acamilo/RobotInterfaceBoard/docs/board.jpeg

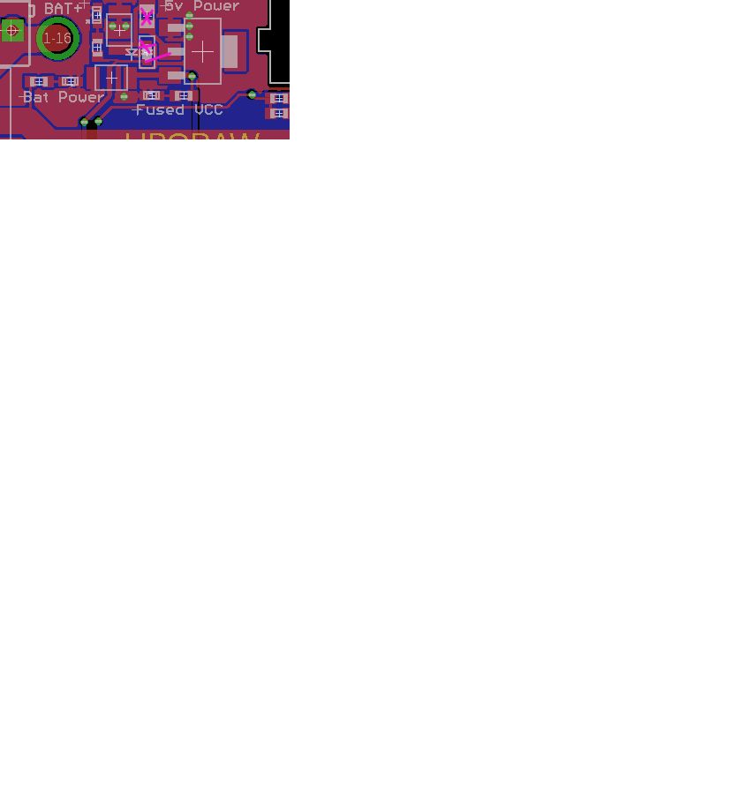
docs/board.jpeg
