acamilo/RobotInterfaceBoard/docs/pickWorkspace.png

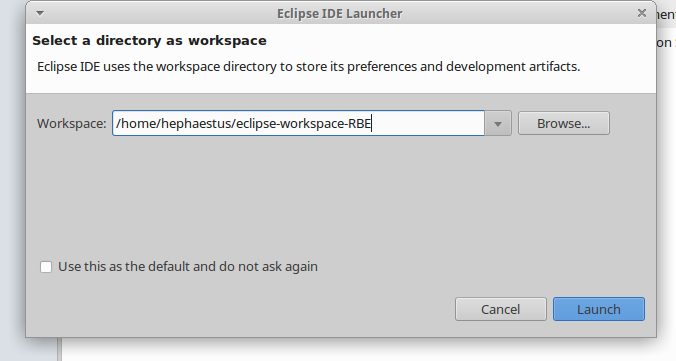
docs/pickWorkspace.png
