acamilo/RobotInterfaceBoard/BOM.xls

Part | Source | Value | Digi-key
C1,C2 | yes | 1210 Capacitor 16v 22uF | 490-1882-1-ND
F4 | no | FUSE BLOCK BLADE 500V 30A PCB | 36-3557-2-ND
IC1 | yes | IC REG LINEAR 5V SOT223 | AZ1117CH-5.0TRG1DICT-ND
J1 | yes | 2 Position Wire to Board Terminal Block | 609-4725-ND
SW1 | no | SWITCH SLIDE DPDT 8.5A 125V | CW174-ND
JP3,JP6,JP7,JP17,JP5,JP19,JP18,JP4,JP2,JP8 | yes | 1X19 0.1” header female | S7017-ND
LED1,LED2,LED3,LED4 | yes | 0603 green LED | 160-1446-1-ND
R1,R2,R3,R4 | yes | 330 ohm Resistors | CR0603-JW-331ELFCT-ND
R5,R6 | yes | 4.7k i2c resistor | RMCF0603JT4K70CT-ND
D1 | no | SOD-523 diode | 1N4148XTPMSCT-ND
PTC | no | PTC fuse 500mA | 490-12122-1-ND
