acamilo/RobotInterfaceBoard/docs/ESP32-setup.png

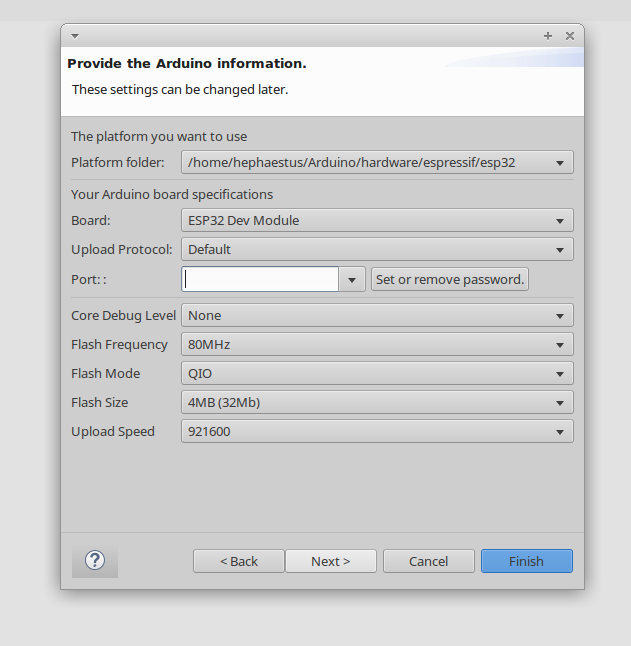
docs/ESP32-setup.png
