acamilo/RobotInterfaceBoard/docs/makeSureThereAreNoSpaces.png

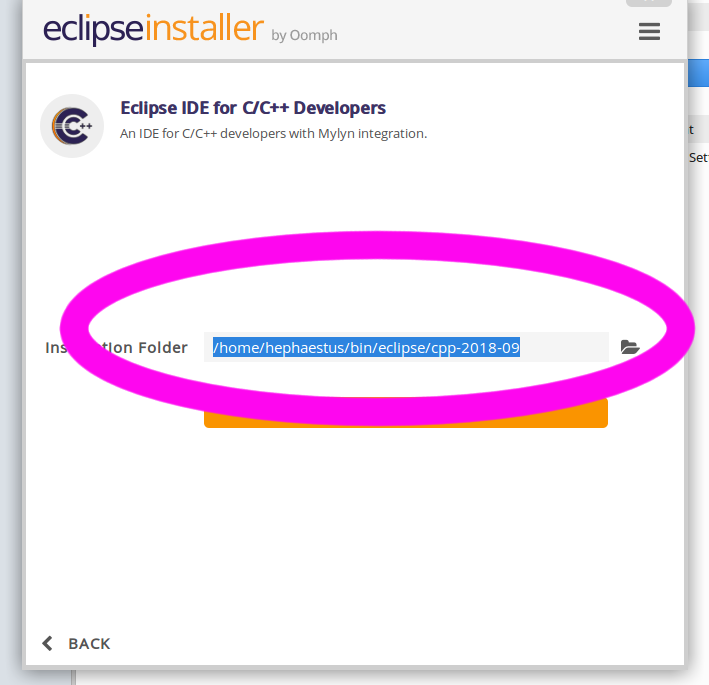
docs/makeSureThereAreNoSpaces.png
