acamilo/RobotInterfaceBoard/docs/fix.png

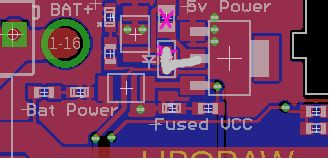
docs/fix.png
