acamilo/RobotInterfaceBoard/(threads)

Thread 2 (2018-02-14):

Battery connector needs to be just a solder lug or screw terminals

madhephaestus, 2018-02-14:
Tamya batteries (RC/Vex standard) will be used.

madhephaestus, 2018-02-15:
When you close issues, do it by putting " close #2 " in the commit message (for this issues example). Otherwise add a comment to the issue with a link to the commit that resolved it.

Thread 3 (2018-02-14):

i2c on the ESP32 pinout is wrong

madhephaestus, 2018-02-14:
SDA is wired to the wrong pin, SCL is correct

SDA is on pin 21

https://1.bp.blogspot.com/-RL8tkZprmjc/WMxXKaIgocI/AAAAAAAAALw/xLM5Qt3jgSALQ_hHRaurJswgGK5G4wVxwCLcB/s1600/myESP32%2BDevKitC%2Bpinout.png

madhephaestus, 2018-02-15:
was this addressed in 6599b58898455c9383d5c74dc5f69e0b3ae3689a

Closed 2018-02-27.

Thread 5 (2018-02-14):

Full-turn order needs to be prepared

madhephaestus, 2018-02-14:
A full-turn of all components assembled onto the PCB is the deliverable for this project. Only the solder lug for the battery should be left out of the full turn.

Closed 2018-03-02.

Thread 6 (2018-02-14):

Fuse and HV traces need to be rated at 10 amps

madhephaestus, 2018-02-14:
The high voltage rail should be rated for 10 amps. The spade/micro automotive style fuse block is preferred.

acamilo, 2018-02-27:
You can get 8 amps if we order with 2oz copper.

Closed 2018-02-27.

Thread 7 (2018-02-15):

Label The power and ground rails in the silk screen

madhephaestus, 2018-02-15:
The nominal voltage on each rail should be labeled

acamilo, 2018-02-27:
e11350b2db6f91e75a6885dfff64264cca3c1889

Closed 2018-02-27.

Thread 8 (2018-02-15):

Label the WII connector pins

madhephaestus, 2018-02-15:
Power, ground, SDA, SCL and controller connect should be labeled.

acamilo, 2018-02-27:
328f9fd04364140250007d0a941541ac70eef136

Closed 2018-02-27.

Thread 9 (2018-02-15):

Controller detect pin should go to the microcontroller

madhephaestus, 2018-02-15:
Both the ESP32 and Teensy should have the controller detect pin rout to an IO pin. If the controller detect needs a pull up or pull down to work, add that as well to the pin.

acamilo, 2018-02-27:
49d743ca390d077daf4d072be6042b93ec0343ef

madhephaestus, 2018-02-27:
which IO pin does it go to?

acamilo, 2018-02-27:
32 on teensy and 23 on esp

madhephaestus, 2018-04-09:
please move the controller detect to a non servo/non SPI pin. Pin GPIO27 is ideal. Did you add a pull-up or pull down?

Closed 2018-02-27.

Thread 13 (2018-03-11):

Fuse is difficult to remove, needs to be moved on Esp32

madhephaestus, 2018-03-11:
The fuse on the Esp32 is very difficult to remove. If it were moved close to the HV rial, then it would be much easier. Pliers need a 15mm keep-away on either side of the open section of the fuse holder. Right now both the switch and the delicate antenna are in the way fr a clean fuse removal.

acamilo, 2018-03-22:
Replaced both fuses with a blade style automotive fuse.

Closed 2018-03-22.

Thread 14 (2018-03-11):

Fuse good/external power/Regulator good indicator LED's needed

madhephaestus, 2018-03-11:
There should be 3 LED's, one for the battery, one for the battery after the fuse, one for the 5v rail. In production environment of use cases with these modules, a visual check is a huge time saver.

acamilo, 2018-03-22:
Added.

Closed 2018-03-22.

Thread 15 (2018-03-11):

Centroid file doesn't contain any connectors

madhephaestus, 2018-03-11:
I was attempting to parse the centroid file to obtain the connector and switch locations for accurate cad. This information is missing.

madhephaestus, 2018-03-21:
This would prevent this part being added to the assembly quote, so what got quoted?

acamilo, 2018-03-22:
Manufacturer does not require centroids for through hole parts.

Closed 2018-03-22.

Thread 18 (2018-03-22):

Fix footprint for fuse holder

acamilo, 2018-03-22:

acamilo, 2018-04-13:
commit 378948bfd3b973c9b04a3b0fbeefe2d49848e643

Closed 2018-04-13.

Thread 19 (2018-03-28):

4k7 ohm pullups to 3.3v are needed on SDA and SCL

madhephaestus, 2018-03-28:
A pullup between SDA and 3.3 and SCL and 3.3 is needed for stable I2C communications across all commercially availible Wii devices. SOme devices have pullups built in, but these devices are unaffected by the external pullups. Some devices do not have these resistors built in and are unstable on the board without them.

madhephaestus, 2018-03-28:
This has been tested and validated as the stable solution in all cases for the Wii devices as a single device on the i2C port. When busing, this may be an issue.

madhephaestus, 2018-04-03:
Note this is needed on both the ESP32 and the Teensy

acamilo, 2018-04-12:
commit ecb4b3a3e98c0dec2cd3e581c8bc03964b119612

Closed 2018-04-12.

Thread 20 (2018-03-28):

BOM needs be updated for v 5.1

madhephaestus, 2018-03-28:
The BOM still lists the SMT style fuse holder

madhephaestus, 2018-05-03:
depends on #25

acamilo, 2018-05-07:
commit 120b008ea8a7410b9db4549d1077ed1a1c80a222

Closed 2018-05-07.

Thread 21 (2018-03-28):

Fuse for the 3.3v regulator is needed (Value is in question)

madhephaestus, 2018-03-28:
A fuse to gracefully fail after the 3.3v rail is plugged directly into gnd, or if the modules 3.3v rail is shorted directly to ground. I assume 75% of the regulators maximum output is sufficient. Be sure to also look at the power spec for the ESP development boards built in. This regulator has fried on a large-ish number of our testing boards. Changing those fusing is much better than replacing all of the power regulators *when* the students short power to ground.

madhephaestus, 2018-03-28:
An additional LED for the 3.3v rail should be here added. I will need to be able to power the module on and see at a glance if all the power rails are up and running.

acamilo, 2018-04-13:
commit 5c16eed2d937238d69e448bf987ce9fe361f2ba1

Closed 2018-04-13.

Thread 22 (2018-04-02):

Solder lugs resized to 3MM diameter holes and moved

madhephaestus, 2018-04-02:
The solder lugs should be one on either side of the screw terminals. The negative lig next to the negative screw terminal, the positive lug next to the positive terminal.

The hole size should also increased to a 3mm diameter.

acamilo, 2018-04-12:
commit aa292d349034c036d6087202d747d3fdc3d7bb37

Closed 2018-04-12.

Thread 24 (2018-04-02):

New SS lables for Analog and servo

madhephaestus, 2018-04-02:
the block of pins that can be analog are:
The ADC driver API currently only supports ADC1 (9 channels, attached to GPIOs 32-39).

They should have some sort of block label. The only area of the board visable to the user is between the 3 pin header and the 1xX header, so maybe highlight the IO or make it inverted colors?

PWM capable pins should be labled too as servos

acamilo, 2018-04-26:
commit f520d1e9d8a9c18e37b3da901794a7398df4641f

Closed 2018-04-26.

Thread 25 (2018-04-03):

Change the last male header, the 1xN, to female.

madhephaestus, 2018-04-03:
This llows solid wire to jumper from one pin to another. It also allows adding caps and resistors on the fly to a pin without disturbing its IO nor resorting to a female wire.

acamilo, 2018-05-07:
commit 120b008ea8a7410b9db4549d1077ed1a1c80a222

Closed 2018-05-07.

Thread 26 (2018-04-03):

Disconnect specific IO used by System Resources on ESP32

madhephaestus, 2018-04-03:
These should be availible in the 1xN header, but stop short of the 3 pin header bank. Thier SS should be changed from the GPIO lable to the name of the perpheral that is consuming them.

Setting any flash GPIO to Servo the module fails to boot. Using the boot pin causes unreliable programming. Using the Wii pins causes the Wii to fail.

Used by Flash:
GPIO6
GPIO7
GPIO8
GPIO9
GPIO10
GPIO11

Used as boot flag:

GPIO0

Used by Wii

GPIO21
GPIO22

Thread 27 (2018-04-03):

Label Signal Power Gnd on the low voltage side

madhephaestus, 2018-04-03:
The High voltage side is labeled, the other side needs labels too.

acamilo, 2018-04-30:
commit 10fba1676815b0f92a9e55add8aa241042beac04

Closed 2018-04-30.

Thread 28 (2018-04-04):

README is needed with with images of the PCB

madhephaestus, 2018-04-04:
The pin-out chart and images of the PCB should be documented in a readme.

acamilo, 2018-04-30:
image and readme. commit aacbf4db9cf578f667deced08ac7219cd93af76e

Closed 2018-04-30.

Thread 30 (2018-04-04):

5v pin outputs 2.72 volts when on battery

madhephaestus, 2018-04-04:
This pin should be removed from the IO interface as its voltage will vary widely based on if you are on battery or plugged in via USB.

Alternantly a separate 5v regulator could be added to that pin to supply voltage for the ESP32. This would keep the interface consistent through modes.

Do not replace the 3.3v regulator, it should be used to provide current for the sensors, should not come from the ESP32 built in regulator unless a a fuse is placed in line the prevent overcurrent of the 3.3 rail

Thread 31 (2018-04-08):

Label servo possible pins with a "~"

madhephaestus, 2018-04-08:
On these pins:
2,4,12-19,21-23,25-27,32-33

place a ~ to denote servo capable. The library for servos on the ESP32 enforces this and will not start servo on any of the other pins.

madhephaestus, 2018-04-08:
See this section in the (now official) esp32 servo library:
https://github.com/madhephaestus/ESP32Servo/blob/master/src/ESP32Servo.cpp#L119

acamilo, 2018-04-20:
commit bc8adbd48c6331260e6b21ed062c8a8094448461

Closed 2018-04-20.

Thread 32 (2018-04-08):

ESP32 needs a user accessible LED on 13

madhephaestus, 2018-04-08:
The built in LED indicates power. An LED that the user can blink on the expected Pin 13 should be added to the breakout board.

This LED should be a different color to the Power status LED's

acamilo, 2018-04-12:
commit 6a48be03bf1fe15c5bb44a22ef9560f14165970c

Closed 2018-04-12.

Thread 33 (2018-04-08):

Jumper select power source for non HV rail

madhephaestus, 2018-04-08:
The regulated rail should pull its power from a jumper selecting either regulated or raw battery.

acamilo, 2018-04-13:
commit cd07d2bb7b7b1c4fb48336a840be50f6b24687e9

Closed 2018-04-13.

Thread 34 (2018-04-09):

[electrical fault] When ESP32 powered via usb, current is leached by the battery only rail.

madhephaestus, 2018-04-09:
When plugged in over usb, no voltage should be shown on the HV battery rail, but instead it is 2.56 volts.

Thread 35 (2018-04-12):

Split ESP32 board off into it's own file

acamilo, 2018-04-12:

acamilo, 2018-04-12:
fixed in commit 984e39c45da6b6a477c64ceb0952db0c5a7e8744

Closed 2018-04-12.

Thread 37 (2018-04-18):

change to 5v power rail for sensors on 35,34,39,36, lables for 3.3v and 5v towards the outside

madhephaestus, 2018-04-18:
On these pins the power rail should be 5v. Some sensors, specifically AS5162, operate at 3.3v but require a 5v input supply for the internal regulator.

A label indicating this should be placed to the outside of the of the IO bank. When looking at the board in the orientation where you can read the IO labels, the label of the 3.3 or 5v should be to the Left of the IO bank.

Thread 38 (2018-04-20):

Fix broken connections on 3.3v rails

acamilo, 2018-04-20:

acamilo, 2018-04-20:
commit 5c77c20921cba0e8288f32ee21421d43e348a800

Closed 2018-04-20.

Thread 40 (2018-04-30):

Version 5 fuse will hit the antenna

madhephaestus, 2018-04-30:
The esp32 antenna sticks out 6.5mm from the edge of the pins.
The antenna keep-away is wrong.
More importantly, the fuse will collide with the esp32.
The fuse should be moved to the right side and aligned so that its footprint is outside of (entirely to the right) the keepaway zone for the antenna.

acamilo, 2018-05-03:
commit 20b6ec96d9e185f649e87e3419c40954de28a7cf

Closed 2018-05-03.

Thread 42 (2018-05-03):

release format and repo contents

madhephaestus, 2018-05-03:
Never version control zip files nor "binaries" such as the gerbers. Every future checkout needs to clone that down now...

Gerber zip files and BOM belong in the release attached as binaries. A collaborator or potential user might want to produce a board, all they should need to look at is the release.

I'm not trying to be nit-picky, its just that i want to be able to point students at this repo as an example of how to organize PCB's into version control.

acamilo, 2018-05-07:
its in the history. no fixing that. I just RM'd them so they don't show up in the files.

Closed 2018-05-07.

Thread 44 (2018-05-03):

Board outline in gerbers is not recognized in JLCPCB

madhephaestus, 2018-05-03:
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

madhephaestus, 2018-05-03:
also has issues with OSHPark
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

Thread 46 (2018-06-04):

v5 BOM is missing the D1 Diode

madhephaestus, 2018-06-04:
The BOM is incomplete

Thread 49 (2020-05-06):

It's possible to buy PCB in Italy

tombo9999, 2020-05-06:
Hi Alex :)
I'm Luca (from Italy). Yesterday I asked some questions to @madhephaestus
He helped me with ESP32encoder library (I'm just an hobbyist).

Sorry to bother you, but it's possible to buy the board? Thanks in advance.

Ciao, Luca

madhephaestus, 2020-05-06:
At the moment this board is open source but not availible for sale. We designed it and manufacture them for WPI's Robotics Engineering undergraduate program. To manufacture it yourself you can take the zip file from master to OSHPark.

tombo9999, 2020-05-06:
Thank you :)

Closed 2020-05-06.
