acamilo/RobotInterfaceBoard/Ribv6.kicad_pcb

## KiCad design Ribv6.kicad_pcb (2020-01-31)

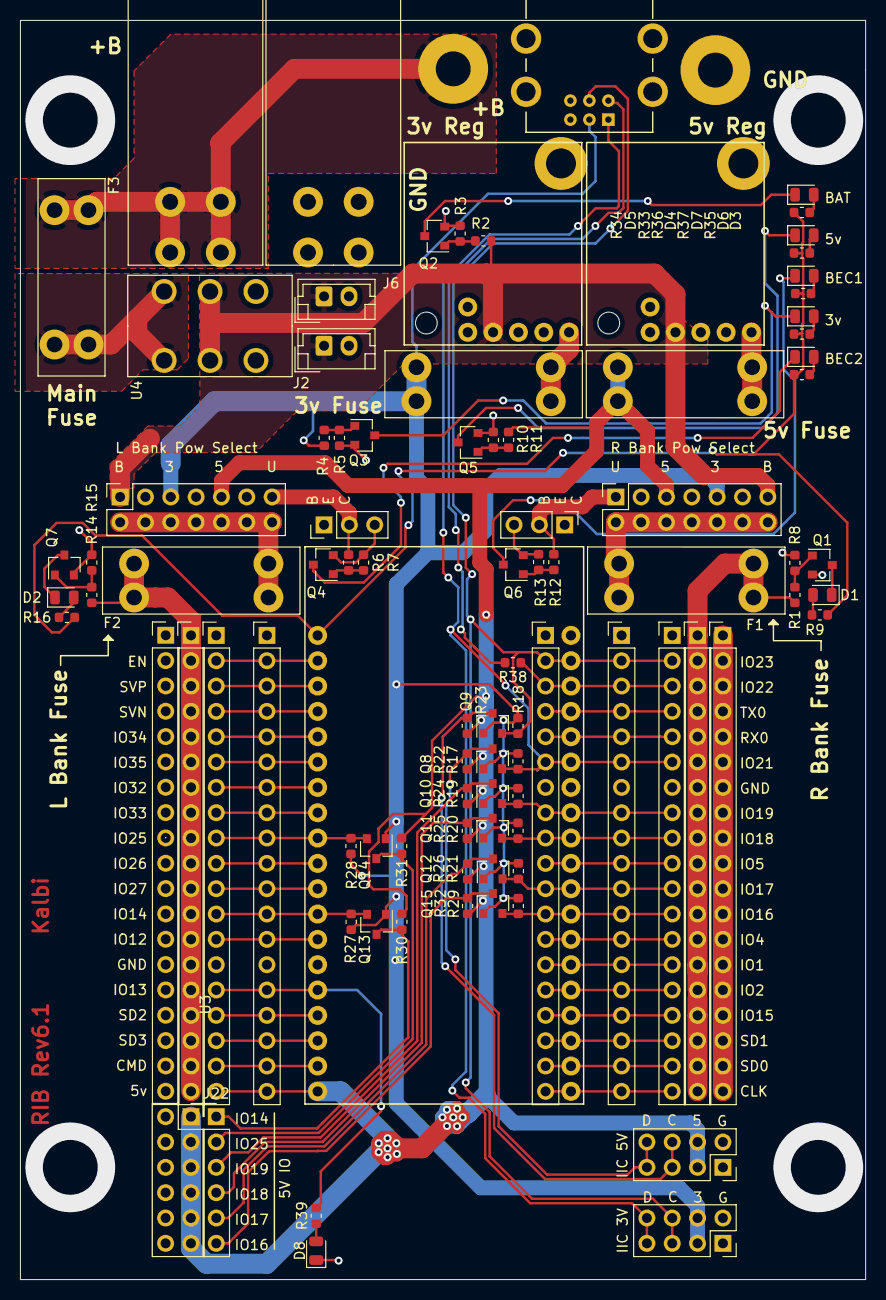
[picture p28: board Ribv6.kicad_pcb from above]

Board: 4 copper layers, 84.7 x 126.2 mm, 95 parts (0 on the bottom side), 80 nets.

Parts:
D1, D2, D3, D4, D5, D6, D7, D8: LED_Small; LED_0805_2012Metric
F1, F2, F3, F4, F5: Fuse; 3557-2
J1, J9: Conn_01x03; PinHeader_1x03_P2.54mm_Vertical
J2, J6: Conn_01x02_Female; JST_EH_B2B-EH-A_1x02_P2.50mm_Vertical
J3, J5, J7, J10, J13, J16, J19, J20, J21: Conn_01x19; PinHeader_1x19_P2.54mm_Vertical
J4, J8: Conn_02x07_Odd_Even; PinSocket_2x07_P2.54mm_Vertical
J11, J26: Conn_01x01_Male; P315100rH
J12, J24: Conn_01x01_Male; MountingHole_3.5mm_Pad
J14, J15: Conn_02x04_Odd_Even; PinSocket_2x04_P2.54mm_Vertical
J22: Conn_01x06; PinHeader_1x06_P2.54mm_Vertical
J23: Conn_02x06_Odd_Even; PinSocket_2x06_P2.54mm_Vertical
J25: Conn_01x06; CONN_WII
Q1, Q2, Q3, Q4, Q5, Q6, Q7, Q8, Q9, Q10, Q11, Q12, Q13, Q14, Q15: BSS138; SOT-23
R1, R2, R3, R4, R5, R6, R7, R8, R10, R11, R12, R13, R14, R15, R34: R_Small; R_0603_1608Metric
R9, R16, R33, R35, R36, R37, R39: 330; R_0603_1608Metric
R17, R18, R19, R20, R21, R22, R23, R24, R25, R26, R27, R28, R29, R30, R31, R32, R38: 10k; R_0603_1608Metric
U1, U2: polulu-3784-D36V28F7
U3: esp-devkit; ESP-DEVKIT
U4: DPDT_x2; GF-126-0327

Connections:
+3.3VA: R9.2, R16.2, R33.2, R34.2, R35.2, R36.2, R37.2, U3.3V3
+3V3: F4.2, J4.9, J8.5, J14.3, J14.4, J25.3, Q8.1, Q9.1, Q10.1, Q11.1, Q12.1, Q13.1, Q14.1, Q15.1, R4.2, R17.2, R18.2, R19.2, R20.2, R21.2, R27.2, R28.2, R29.2
+5V: F5.2, J4.5, J8.9, J13.19, J15.3, J15.4, J16.19, J23.1, J23.3, J23.5, J23.7, J23.9, J23.11, R10.2, R22.2, R23.2, R24.2, R25.2, R26.2, R30.2, R31.2, R32.2, U3.5V
+BATT: J2.1, J4.13, J6.1, J8.1, R2.2, U1.VIN, U2.VIN, U4.2, U4.5
GND: D8.1, J1.3, J2.2, J3.1, J3.2, J3.3, J3.4, J3.5, J3.6, J3.7, J3.8, J3.9, J3.10, J3.11, J3.12, J3.13, J3.14, J3.15, J3.16, J3.17, J3.18, J3.19, J6.2, J9.3, J10.1, J10.2, J10.3, J10.4, J10.5, J10.6, J10.7, J10.8, J10.9, J10.10, J10.11, J10.12, J10.13, J10.14, J10.15, J10.16, J10.17, J10.18, J10.19, J13.14, J14.1, J14.2, J15.1, J15.2, J16.14, J19.7, J20.7, J21.7, J23.2, J23.4, J23.6, J23.8, J23.10, J23.12, J24.1, J25.6, J26.1, Q1.2, Q2.2, Q3.2, Q4.2, Q5.2, Q6.2, Q7.2, R3.1, R5.1, R7.1, R8.1, R11.1, R13.1, R15.1, U1.GND, U2.GND, U3.GND
GPIO14: J13.12, J16.12, Q13.2, R27.1, U3.IO14
GPIO14_5: J22.1, Q13.3, R30.1
GPIO16: J19.12, J20.12, J21.12, Q15.2, R29.1, U3.IO16
GPIO16_5: J22.6, Q15.3, R32.1
GPIO17: J19.11, J20.11, J21.11, Q12.2, R21.1, U3.IO17
GPIO17_5: J22.5, Q12.3, R26.1
GPIO18: J19.9, J20.9, J21.9, Q11.2, R20.1, U3.IO18
GPIO18_5: J22.4, Q11.3, R25.1
GPIO19: J19.8, J20.8, J21.8, Q10.2, R19.1, U3.IO19
GPIO19_5: J22.3, Q10.3, R24.1
GPIO25: J13.9, J16.9, Q14.2, R28.1, U3.IO25
GPIO25_5: J22.2, Q14.3, R31.1
unnamed: D1.1, Q1.3
unnamed: D1.2, R9.1
unnamed: D2.1, Q7.3
unnamed: D2.2, R16.1
unnamed: D3.1, Q2.3
unnamed: D3.2, R35.1
unnamed: D4.1, Q3.3
unnamed: D4.2, R33.1
unnamed: D5.1, Q4.3
unnamed: D5.2, R34.1
unnamed: D6.1, Q5.3
unnamed: D6.2, R37.1
unnamed: D7.1, Q6.3
unnamed: D7.2, R36.1
unnamed: D8.2, R39.1
unnamed: F1.1, J4.2, J4.4, J4.6, J4.8, J4.10, J4.12, J4.14
unnamed: F2.1, J8.2, J8.4, J8.6, J8.8, J8.10, J8.12, J8.14
unnamed: F3.1, J11.1, J12.1
unnamed: F3.2, U4.3, U4.4
unnamed: F4.1, U1.VOUT
unnamed: F5.1, U2.VOUT
unnamed: J13.2, J16.2, U3.EN
unnamed: J13.3, J16.3, U3.SVP
unnamed: J13.4, J16.4, U3.SVN
unnamed: J13.5, J16.5, U3.IO34
unnamed: J13.6, J16.6, U3.IO35
unnamed: J13.7, J16.7, U3.IO32
unnamed: J13.8, J16.8, U3.IO33
unnamed: J13.10, J16.10, U3.IO26
unnamed: J13.11, J16.11, U3.IO27
unnamed: J13.13, J16.13, U3.IO12
unnamed: J13.15, J16.15, R39.2, U3.IO13
unnamed: J13.16, J16.16, U3.SD2
unnamed: J13.17, J16.17, U3.SD3
unnamed: J13.18, J16.18, U3.CMD
unnamed: J19.3, J20.3, J21.3, R38.1, U3.IO22
unnamed: J19.4, J20.4, J21.4, U3.TX0
unnamed: J19.5, J20.5, J21.5, U3.RX0
unnamed: J19.10, J20.10, J21.10, U3.IO5
unnamed: J19.13, J20.13, J21.13, U3.IO4
unnamed: J19.14, J20.14, J21.14, U3.IO1
unnamed: J19.15, J20.15, J21.15, U3.IO2
unnamed: J19.16, J20.16, J21.16, U3.IO15
unnamed: J19.17, J20.17, J21.17, U3.SD1
unnamed: J19.18, J20.18, J21.18, U3.SD0
unnamed: J19.19, J20.19, J21.19, U3.CLK
unnamed: Q1.1, R1.1, R8.2
unnamed: Q2.1, R2.1, R3.2
unnamed: Q3.1, R4.1, R5.2
unnamed: Q4.1, R6.1, R7.2
unnamed: Q5.1, R10.1, R11.2
unnamed: Q6.1, R12.1, R13.2
unnamed: Q7.1, R14.1, R15.2
unnamed: U4.1, U4.6
Rail1: F1.2, J5.1, J5.2, J5.3, J5.4, J5.5, J5.6, J5.7, J5.8, J5.9, J5.10, J5.11, J5.12, J5.13, J5.14, J5.15, J5.16, J5.17, J5.18, J5.19, R1.2
Rail2: F2.2, J7.1, J7.2, J7.3, J7.4, J7.5, J7.6, J7.7, J7.8, J7.9, J7.10, J7.11, J7.12, J7.13, J7.14, J7.15, J7.16, J7.17, J7.18, J7.19, R14.2
SCL_5: J15.5, J15.6, Q9.3, R23.1
SCL_33: J14.5, J14.6, J19.2, J20.2, J21.2, J25.4, Q9.2, R18.1, U3.IO23
SDA_5: J15.7, J15.8, Q8.3, R22.1
SDA_33: J14.7, J14.8, J19.6, J20.6, J21.6, J25.1, Q8.2, R17.1, U3.IO21
UBEC1: J1.2, J4.1, R12.2
UBEC2: J8.13, J9.2, R6.2
prez: J25.2, R38.2
