acamilo/RobotInterfaceBoard/(commit log)

2017-11-30 Rev 3 commit
    [Rib.brd, Rib.sch]
2018-02-15 Updated Locking connecter library footprint with more clearence for locking pins
2018-02-15 Updated PCB footprints with updated wiichuck footprint
    [Rib.brd, Rib.sch]
2018-02-15 Replaced JST power connectors with screw terminals
    [Rib.brd, Rib.sch]
2018-02-15 Moved teensy power connector and added solder lugs for a cable to both boards
    [Rib.brd]
2018-02-15 ESP32 SDA now on pin 21
    [Rib.brd, Rib.sch]
2018-02-27 label wii connector pins
    [Rib.brd]
2018-02-27 label Power and GND on battery connection
    [Rib.brd]
2018-02-27 DET pins routed to esp and teensy
    [Rib.brd, Rib.sch]
2018-02-27 upped rev no to 4
    [Rib.brd]
2018-03-02 BOM and Centroid added
    [BOM.xls, Rib_centroid.csv]
2018-03-02 Gerbers added
2018-03-02 DK parts for all lines
    [BOM.xls]
2018-03-22 Replaced fuseholder with blade style automotive fuse
    [Rib.brd, Rib.sch]
2018-03-22 Added Power, Fuse, Regulated satus LEDs
    [Rib.brd, Rib.sch]
2018-04-12 Issue #35: Split esp32 board off into its own file
    [Rib-BabyBack.brd, Rib-BabyBack.sch]
2018-04-12 Issue #26 Disconnect specific IO used by System Resources on ESP32
    [Rib-BabyBack.brd, Rib-BabyBack.sch]
2018-04-12 Issue #32 ESP32 needs a user accessible LED on 13
    [Rib-BabyBack.brd, Rib-BabyBack.sch]
2018-04-12 Issue #22 Solder lugs resized to 3MM diameter holes and moved
    [Rib-BabyBack.brd, Rib-BabyBack.sch]
2018-04-12 Issue #19 4k7 ohm pullups to 3.3v are needed on SDA and SCL
    [Rib-BabyBack.brd, Rib-BabyBack.sch]
2018-04-13 Issue #18 Fix footprint for fuse holder
2018-04-13 Issue #21 Added a pad for a PTC resetabble fuse for the 3.3v rail
    [Rib-BabyBack.brd, Rib-BabyBack.sch]
2018-04-13 Issues #33 and 4 and #36
    [Rib-BabyBack.brd, Rib-BabyBack.sch]
2018-04-13 Issue #34
    [Rib-BabyBack.brd, Rib-BabyBack.sch]
2018-04-20 Resolved issue 37
    [Rib-BabyBack.brd, Rib-BabyBack.sch]
2018-04-20 Resolved issue 38
    [Rib-BabyBack.brd, Rib-BabyBack.sch]
2018-04-20 Resolved issue 31
    [Rib-BabyBack.brd]
2018-04-26 Resolved issue #24
    [Rib-BabyBack.brd]
2018-04-26 Resolved issue #23
    [Rib-BabyBack.brd]
2018-04-30 Resolved issue #27
    [Rib-BabyBack.brd]
2018-04-30 added board image and readme. #28
2018-05-03 Moved fuse holder as per #40
    [Rib-BabyBack.brd]
2018-05-03 Updated silkscreen indicating analog pins #41
    [Rib-BabyBack.brd]
2018-05-03 updated board render to reflect new fuse location
2018-05-07 Updated BOM. #20 #25
    [BOM.xls]
2018-06-06 added missing fuse and diode to BOM
    [BOM.xls]
2018-07-16 changed 5v rail
    [Rib-BabyBack.brd, Rib-BabyBack.sch]
2018-07-16 Fixed R1-4 in bom
    [BOM.xls]
2018-08-02 Updated centroid to include surface mount and through hole compnents
    [Rib_centroid.csv]
2018-08-02 added JP9 to BOM
    [BOM.xls]
2019-01-11 adding setup docs to board readme
2019-03-27 highlight the button to press
2019-06-19 added devkit PCB
2019-06-19 Added headers
    [Ribv6.sch]
2019-06-19 power jumpers for rails.
    [Ribv6.sch]
2019-06-19 Add rail fuse and fuse indicators
    [Ribv6.sch]
2019-06-24 i2c circuit
    [Ribv6.sch]
2019-06-24 Update Ribv6.sch
    Added level hifting for 19,18,17,16,25,14
    [Ribv6.sch]
2019-06-24 Added indicator LEDS
    [Ribv6.sch]
2019-06-24 Battery Connector
    [Ribv6.sch]
2019-06-24 Extra header to accomidate shorter modules
    [Ribv6.sch]
2019-06-25 Update Ribv6.sch
    Added connectors for 5v
    removed extra header.
    [Ribv6.sch]
2019-07-02 Fuse FP
2019-07-02 added new features to sch
    [Ribv6.sch]
2019-07-02 first iter of PCB
    [Ribv6.kicad_pcb]
2019-07-02 Removed eagle BRD
    [Rib-BabyBack.brd, Rib.brd]
2019-07-02 fewer i2c conns in schematic
    [Ribv6.sch]
2019-07-08 routing draft
    [Ribv6.sch]
2019-07-08 layout done, partial silk
    [Ribv6.kicad_pcb, Ribv6.sch]
2019-10-16 Added lib for switch.
2019-10-16 re-laying out power section.
    [Ribv6.kicad_pcb, Ribv6.sch]
2019-10-18 Update polulu-3784-D36V28F7.kicad_mod
    Changed top rigt hole to recieve solderable standoff.
2019-10-22 finished routing.
    [Ribv6.kicad_pcb, Ribv6.sch]
2019-10-22 Added LED on pin 13
    #6
    [Ribv6.kicad_pcb, Ribv6.sch]
2020-01-17 Board Updates.
    #3 Updated power system for the rib
    * Bolt holes on a 5.5mm grid
    * Second ehader added so narrow ESP32 devkit can be used
    * Accepts a 7.5 to 18v battery with solder lugs and bannana plugs
    * 5v 2 amp REG for esp32
    * 2 external power converter ports
    * Both banks are switchable via jumpers between sys5, raw, ext reg, sensor 3v3
    * GPIO 0 connects to io
    * RST connects to IO
    * 5v shifter on i2c and 5v i2c on a header.
    * shifted bidirectional 3 to 5 level shifters for pins 19,18,17,16,25,14
    * Updated Silkscreen
    #5 Added a switch
    #6 LED on pin 13
    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
    [Ribv6.kicad_pcb]
2020-01-17 Added labels to power lugs, Bannana jacks #12
    Added labels to power lugs, Bannana jacks #12
    [Ribv6.kicad_pcb]
